PUT-Motorsport/PUTM_EV_BMS_LV_2021/Hardware/Pcb_size.dxf

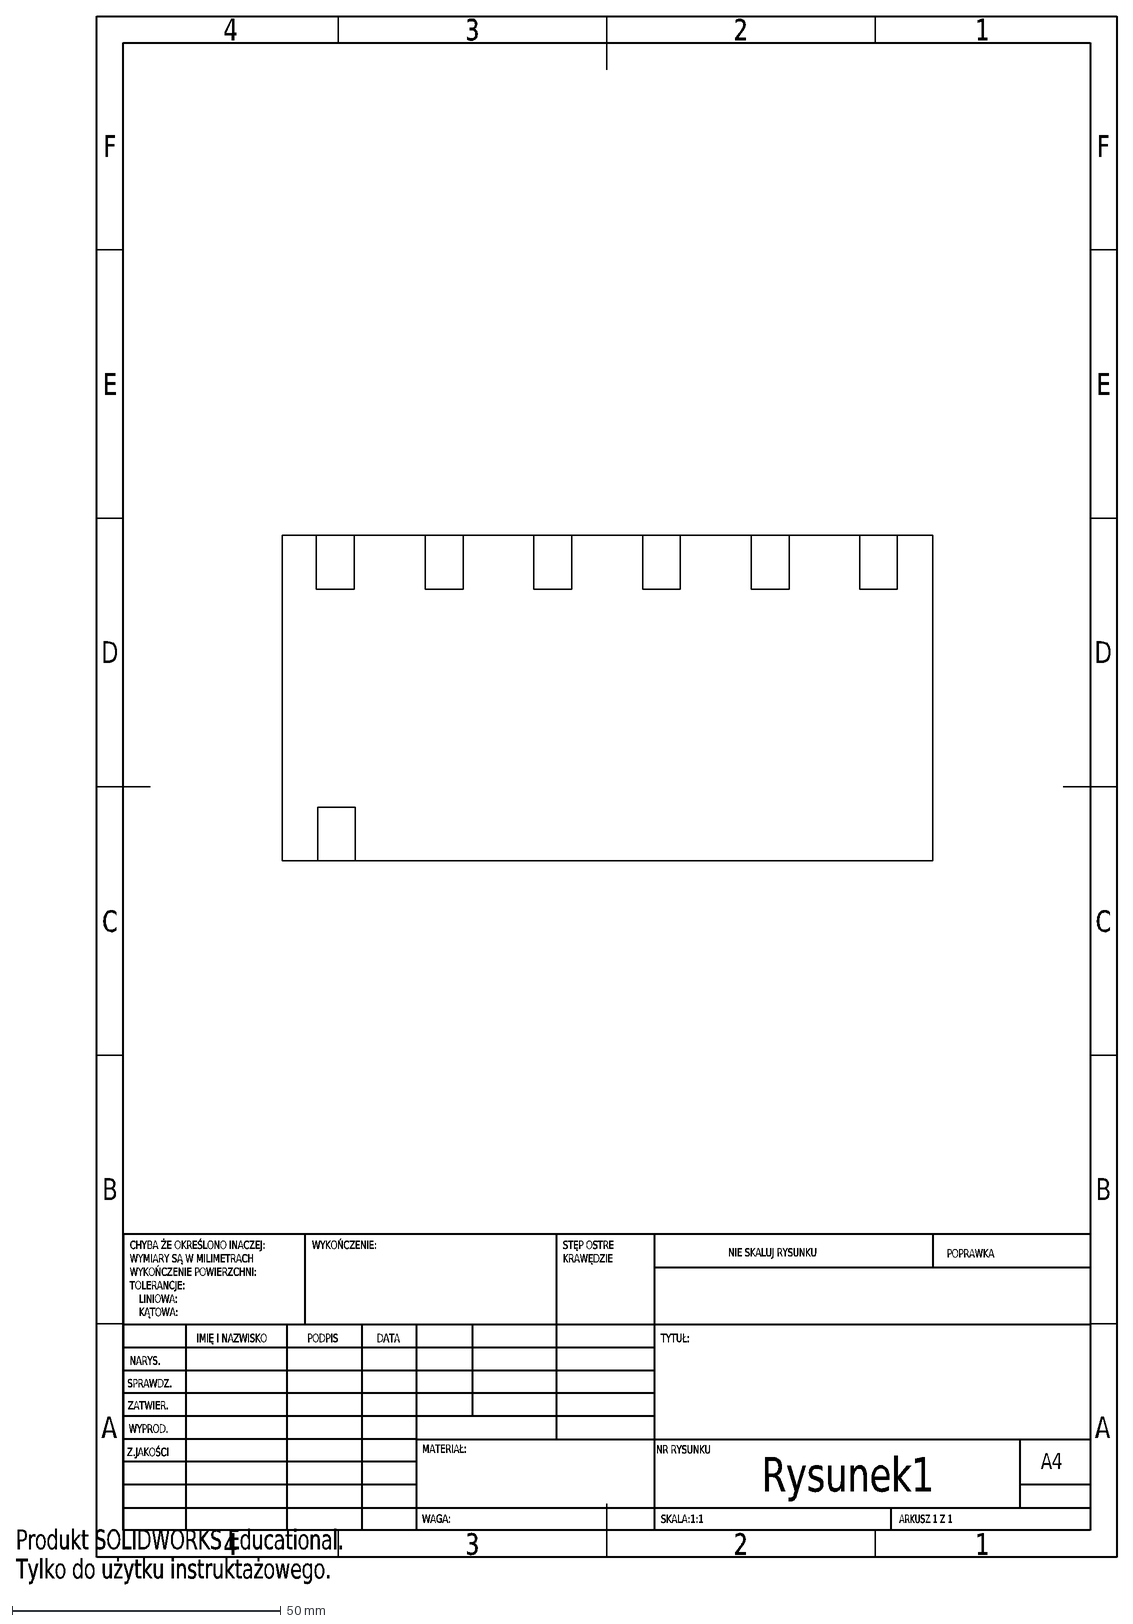
[picture p1: CAD file, 2021-02-14]
Hardware/Pcb_size.dxf
A
B
C
D
E
F
4
3
2
1
NARYS.
SPRAWDZ.
ZATWIER.
WYPROD.
Z.JAKOŚCI
CHYBA ŻE OKREŚLONO INACZEJ:
WYMIARY SĄ W MILIMETRACH
WYKOŃCZENIE POWIERZCHNI:
TOLERANCJE:
LINIOWA:
KĄTOWA:
WYKOŃCZENIE:
STĘP OSTRE
KRAWĘDZIE
IMIĘ I NAZWISKO
PODPIS
DATA
MATERIAŁ:
NIE SKALUJ RYSUNKU
POPRAWKA
TYTUŁ:
NR RYSUNKU
SKALA:1:1
ARKUSZ 1 Z 1
A4
WAGA:
Rysunek1
Produkt SOLIDWORKS Educational.
Tylko do użytku instruktażowego.
