PUT-Motorsport/PUTM_EV_BMS_LV_2021/Hardware/bmsLV.kicad_pcb

## KiCad design Hardware/bmsLV.kicad_pcb (2021-05-10)

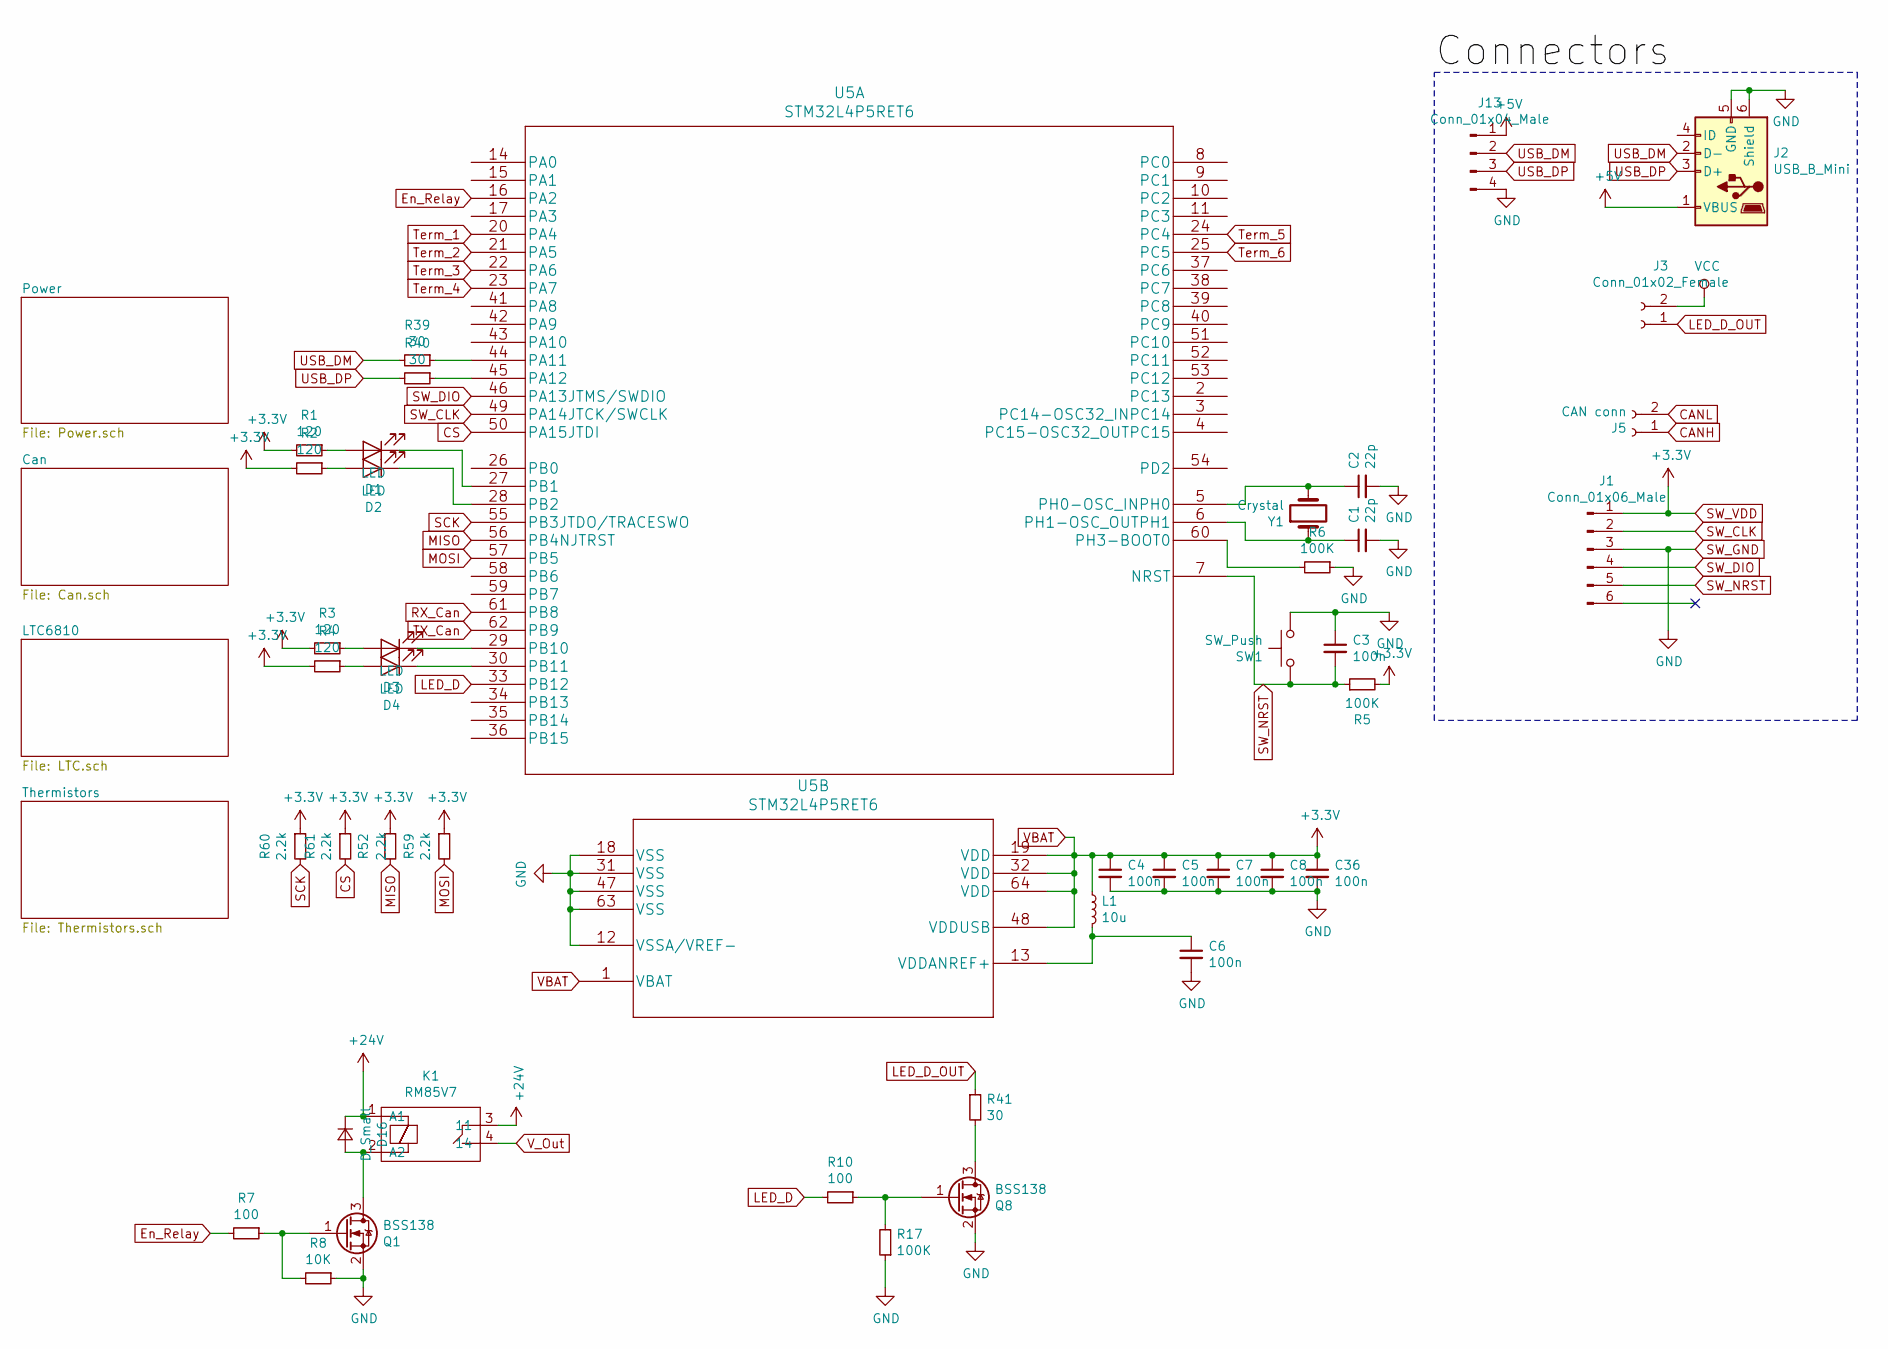
[picture p2: schematic bmsLV.sch]

Parts:
C1, C2: 22p; C_1206_3216Metric
C3, C4, C5, C6, C7, C8, C36: 100n; C_1206_3216Metric
D1, D2, D3, D4: LED; LED_1206_3216Metric
D16: D_Small; D_SMB
J1: Conn_01x06_Male; PinHeader_1x06_P2.54mm_Vertical
J2: USB_B_Mini; USB_Micro-B_Molex_47346-0001
J3: Conn_01x02_Female; PhoenixContact_MSTBVA_2,5_2-G-5,08_1x02_P5.08mm_Vertical
J5: CAN conn; PhoenixContact_MSTBVA_2,5_2-G-5,08_1x02_P5.08mm_Vertical
J13: Conn_01x04_Male; PinHeader_1x04_P2.54mm_Vertical
K1: RM85V7
L1: 10u; L_0805_2012Metric
Q1, Q8: BSS138; SOT-23
R1, R2, R3, R4: 120; R_1206_3216Metric
R5, R6, R17: 100K; R_1206_3216Metric
R7, R10: 100; R_1206_3216Metric
R8: 10K; R_1206_3216Metric
R39, R40, R41: 30; R_1206_3216Metric
R52, R59, R60, R61: 2.2k; R_1206_3216Metric
SW1: SW_Push; SW_PUSH_6mm
U5: STM32L4P5RET6
Y1: Crystal; Crystal_SMD_HC49-SD

Connections:
+5V: J2.1 (VBUS), J13.1; also elsewhere on the board
+24V: D16.1 (K), K1.1 (A1), K1.3 (11); also elsewhere on the board
CANH: J5.1; also elsewhere on the board
CANL: J5.2; also elsewhere on the board
CS: R61.2, U5.50 (PA15JTDI); also elsewhere on the board
En_Relay: R7.2, U5.16 (PA2)
LED_D: R10.2, U5.33 (PB12)
LED_D_OUT: J3.1, R41.1
MISO: R52.2, U5.56 (PB4NJTRST); also elsewhere on the board
MOSI: R59.2, U5.57 (PB5); also elsewhere on the board
unnamed: C1.1, U5.6 (PH1-OSC_OUTPH1), Y1.1
unnamed: C2.1, U5.5 (PH0-OSC_INPH0), Y1.2
unnamed: C6.1, L1.2, U5.13 (VDDANREF+)
unnamed: D1.1 (K), U5.27 (PB1)
unnamed: D1.2 (A), R1.1
unnamed: D2.1 (K), U5.28 (PB2)
unnamed: D2.2 (A), R2.1
unnamed: D3.1 (K), U5.29 (PB10)
unnamed: D3.2 (A), R3.1
unnamed: D4.1 (K), U5.30 (PB11)
unnamed: D4.2 (A), R4.1
unnamed: D16.2 (A), K1.2 (A2), Q1.3 (D)
unnamed: Q1.1 (G), R7.1, R8.2
unnamed: Q8.1 (G), R10.1, R17.2
unnamed: Q8.3 (D), R41.2
unnamed: R6.2, U5.60 (PH3-BOOT0)
unnamed: R39.1, U5.44 (PA11)
unnamed: R40.1, U5.45 (PA12)
RX_Can: U5.61 (PB8); also elsewhere on the board
SCK: R60.2, U5.55 (PB3JTDO/TRACESWO); also elsewhere on the board
SW_CLK: J1.2, U5.49 (PA14JTCK/SWCLK)
SW_DIO: J1.4, U5.46 (PA13JTMS/SWDIO)
SW_GND: C1.2, C2.2, C3.1, C4.2, C5.2, C6.2, C7.2, C8.2, C36.2, J1.3, J2.5 (GND), J2.6 (Shield), J13.4, Q1.2 (S), Q8.2 (S), R6.1, R8.1, R17.1, SW1.2, U5.12 (VSSA/VREF-), U5.18 (VSS), U5.31 (VSS), U5.47 (VSS), U5.63 (VSS); also elsewhere on the board
SW_NRST: C3.2, J1.5, R5.1, SW1.1, U5.7 (NRST)
SW_VDD: C4.1, C5.1, C7.1, C8.1, C36.1, J1.1, L1.1, R1.2, R2.2, R3.2, R4.2, R5.2, R52.1, R59.1, R60.1, R61.1, U5.1 (VBAT), U5.19 (VDD), U5.32 (VDD), U5.48 (VDDUSB), U5.64 (VDD); also elsewhere on the board
TX_Can: U5.62 (PB9); also elsewhere on the board
Term_1: U5.20 (PA4); also elsewhere on the board
Term_2: U5.21 (PA5); also elsewhere on the board
Term_3: U5.22 (PA6); also elsewhere on the board
Term_4: U5.23 (PA7); also elsewhere on the board
Term_5: U5.24 (PC4); also elsewhere on the board
Term_6: U5.25 (PC5); also elsewhere on the board
USB_DM: J2.2 (D-), J13.2, R39.2
USB_DP: J2.3 (D+), J13.3, R40.2
VCC: J3.2; also elsewhere on the board
V_Out: K1.4 (14)

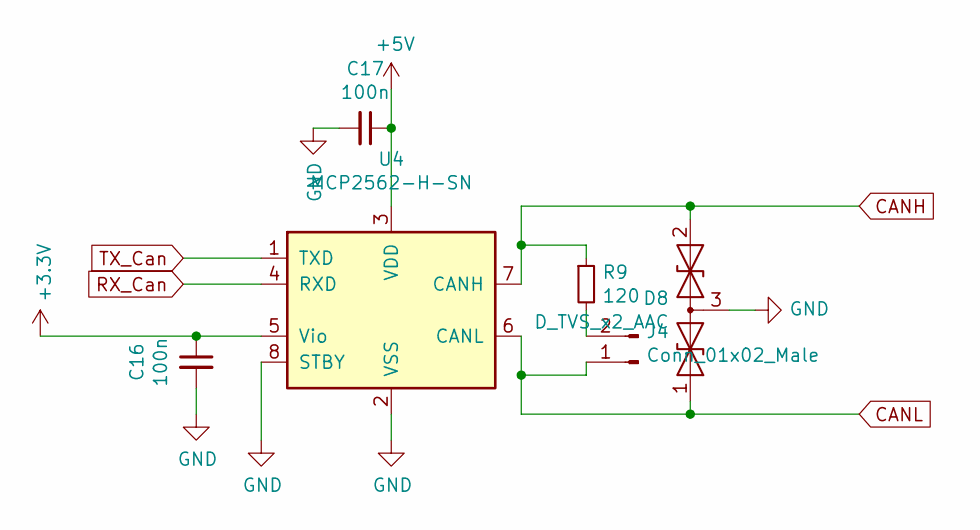
[picture p3: schematic Can.sch]

Parts:
C16, C17: 100n; C_1206_3216Metric
D8: D_TVS_x2_AAC; SOT-23
J4: Conn_01x02_Male; PinHeader_1x02_P2.54mm_Vertical
R9: 120; R_1206_3216Metric
U4: MCP2562-H-SN; SOIC-8_3.9x4.9mm_P1.27mm

Connections:
+5V: C17.1, U4.3 (VDD); also elsewhere on the board
CANH: D8.2 (A2), R9.1, U4.7 (CANH); also elsewhere on the board
CANL: D8.1 (A1), J4.1, U4.6 (CANL); also elsewhere on the board
unnamed: J4.2, R9.2
RX_Can: U4.4 (RXD); also elsewhere on the board
SW_GND: C16.2, C17.2, D8.3 (common), U4.2 (VSS), U4.8 (STBY); also elsewhere on the board
SW_VDD: C16.1, U4.5 (Vio); also elsewhere on the board
TX_Can: U4.1 (TXD); also elsewhere on the board

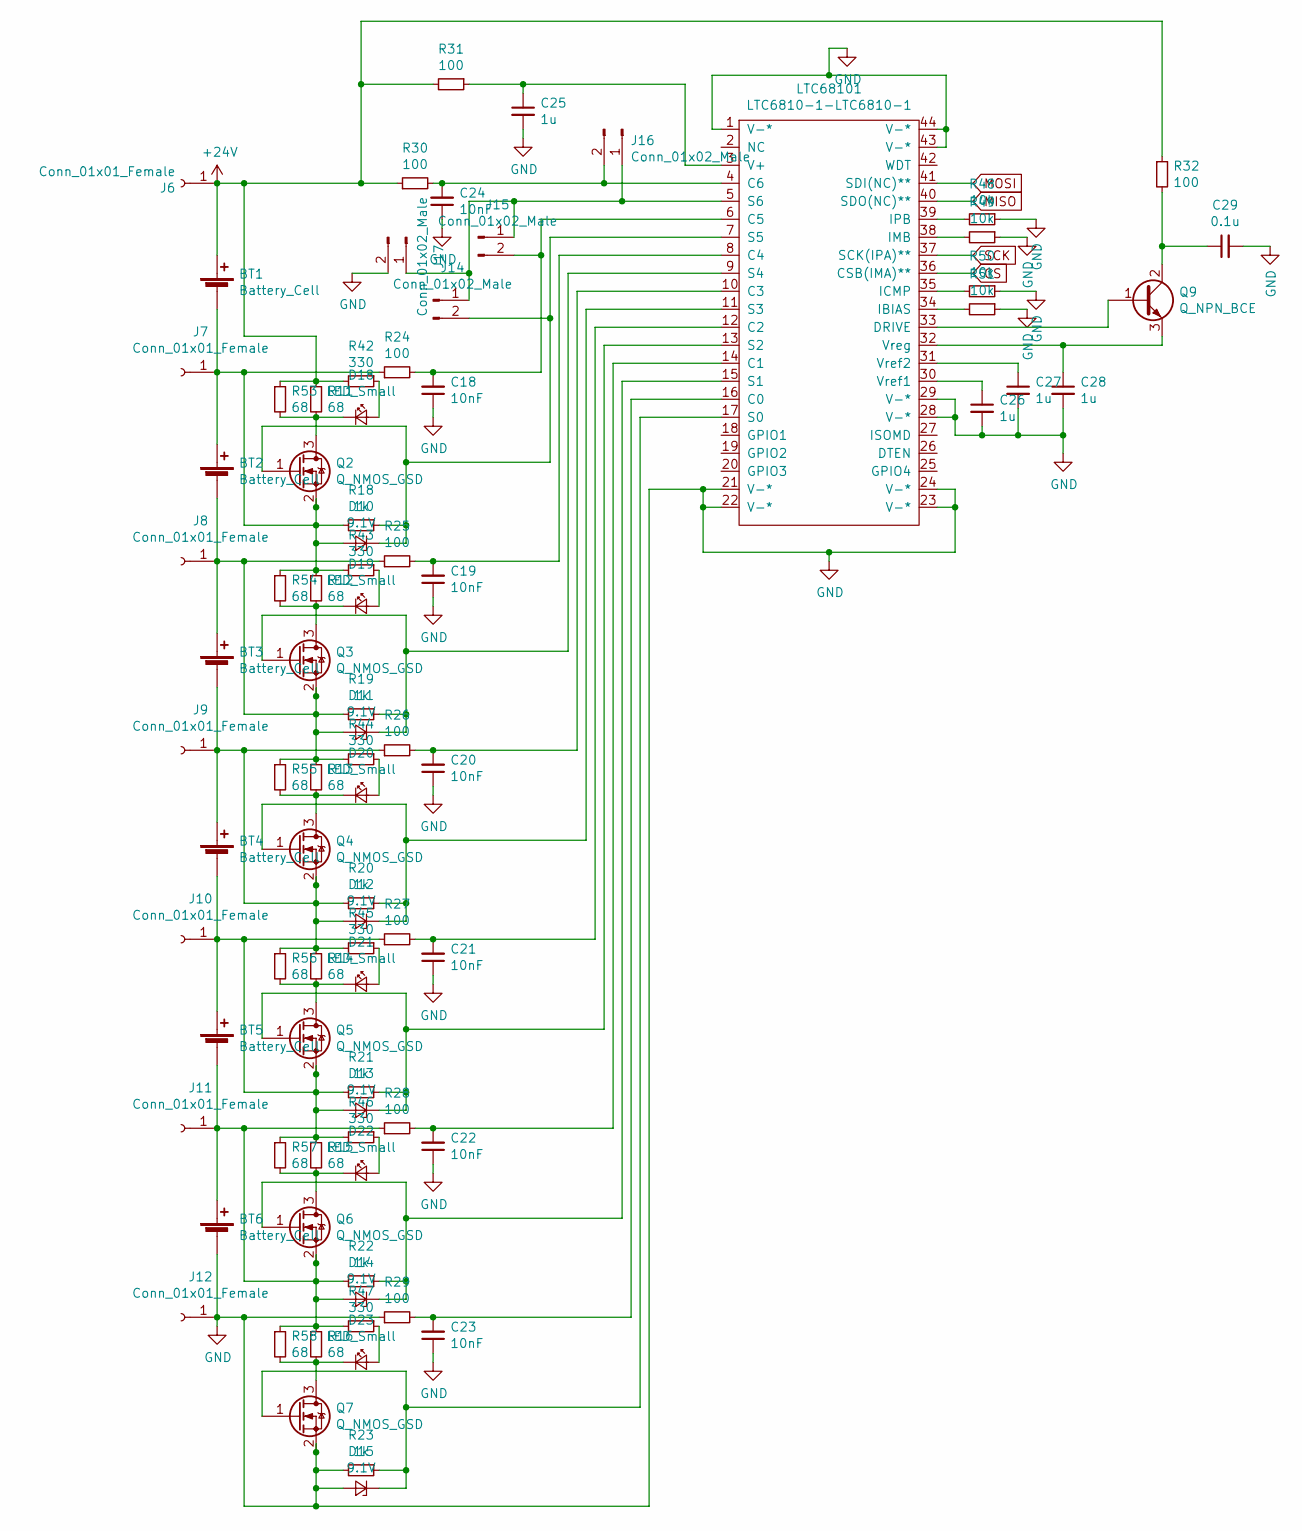
[picture p4: schematic LTC.sch]

Parts:
BT1, BT2, BT3, BT4, BT5, BT6: Battery_Cell; TerminalBlock_bornier-2_P5.08mm
C18, C19, C20, C21, C22, C23, C24: 10nF; C_1206_3216Metric
C25, C26, C27, C28: 1u; C_1206_3216Metric
C29: 0.1u; C_0603_1608Metric
D10, D11, D12, D13, D14, D15: 9.1V; D_SMB
D18, D19, D20, D21, D22, D23: LED_Small; LED_0805_2012Metric
J6, J7, J8, J9, J10, J11, J12: Conn_01x01_Female; CellPad
J14, J15, J16, J17: Conn_01x02_Male; SolderJumper-2_P1.3mm_Open_RoundedPad1.0x1.5mm
LTC68101: LTC6810-1-LTC6810-1; LTC6810
Q2, Q3, Q4, Q5, Q6, Q7: Q_NMOS_GSD; SOT-23
Q9: Q_NPN_BCE; SOT-23W
R11, R12, R13, R14, R15, R16, R53, R54, R55, R56, R57, R58: 68; R_2512_6332Metric
R18, R19, R20, R21, R22, R23: 1k; R_1206_3216Metric
R24, R25, R26, R27, R28, R29, R30, R31, R32: 100; R_1206_3216Metric
R42, R43, R44, R45, R46, R47: 330; R_1206_3216Metric
R48, R49, R50, R51: 10k; R_0805_2012Metric

Connections:
+24V: BT1.1 (+), J6.1, R11.1, R30.1, R31.2, R32.1, R42.2, R53.1; also elsewhere on the board
CS: LTC68101.36 (CSB(IMA)**); also elsewhere on the board
MISO: LTC68101.40 (SDO(NC)**); also elsewhere on the board
MOSI: LTC68101.41 (SDI(NC)**); also elsewhere on the board
unnamed: BT1.2 (-), BT2.1 (+), D10.2 (A), J7.1, Q2.2 (S), R12.1, R18.2, R24.1, R43.2, R54.1
unnamed: BT2.2 (-), BT3.1 (+), D11.2 (A), J8.1, Q3.2 (S), R13.1, R19.2, R25.1, R44.2, R55.1
unnamed: BT3.2 (-), BT4.1 (+), D12.2 (A), J9.1, Q4.2 (S), R14.1, R20.2, R26.1, R45.2, R56.1
unnamed: BT4.2 (-), BT5.1 (+), D13.2 (A), J10.1, Q5.2 (S), R15.1, R21.2, R27.1, R46.2, R57.1
unnamed: BT5.2 (-), BT6.1 (+), D14.2 (A), J11.1, Q6.2 (S), R16.1, R22.2, R28.1, R47.2, R58.1
unnamed: C18.2, J15.2, LTC68101.6 (C5), R24.2
unnamed: C19.2, LTC68101.8 (C4), R25.2
unnamed: C20.2, LTC68101.10 (C3), R26.2
unnamed: C21.2, LTC68101.12 (C2), R27.2
unnamed: C22.2, LTC68101.14 (C1), R28.2
unnamed: C23.2, LTC68101.16 (C0), R29.2
unnamed: C24.2, J16.2, LTC68101.4 (C6), R30.2
unnamed: C25.1, LTC68101.3 (V+), R31.1
unnamed: C26.1, LTC68101.30 (Vref1)
unnamed: C27.1, LTC68101.31 (Vref2)
unnamed: C28.1, LTC68101.32 (Vreg), Q9.3 (E)
unnamed: C29.1, Q9.2 (C), R32.2
unnamed: D10.1 (K), J14.2, LTC68101.7 (S5), Q2.1 (G), R18.1
unnamed: D11.1 (K), LTC68101.9 (S4), Q3.1 (G), R19.1
unnamed: D12.1 (K), LTC68101.11 (S3), Q4.1 (G), R20.1
unnamed: D13.1 (K), LTC68101.13 (S2), Q5.1 (G), R21.1
unnamed: D14.1 (K), LTC68101.15 (S1), Q6.1 (G), R22.1
unnamed: D15.1 (K), LTC68101.17 (S0), Q7.1 (G), R23.1
unnamed: D18.1 (K), Q2.3 (D), R11.2, R53.2
unnamed: D18.2 (A), R42.1
unnamed: D19.1 (K), Q3.3 (D), R12.2, R54.2
unnamed: D19.2 (A), R43.1
unnamed: D20.1 (K), Q4.3 (D), R13.2, R55.2
unnamed: D20.2 (A), R44.1
unnamed: D21.1 (K), Q5.3 (D), R14.2, R56.2
unnamed: D21.2 (A), R45.1
unnamed: D22.1 (K), Q6.3 (D), R15.2, R57.2
unnamed: D22.2 (A), R46.1
unnamed: D23.1 (K), Q7.3 (D), R16.2, R58.2
unnamed: D23.2 (A), R47.1
unnamed: J14.1, J15.1, J16.1, J17.1, LTC68101.5 (S6)
unnamed: LTC68101.33 (DRIVE), Q9.1 (B)
unnamed: LTC68101.34 (IBIAS), R51.2
unnamed: LTC68101.35 (ICMP), R50.2
unnamed: LTC68101.38 (IMB), R49.2
unnamed: LTC68101.39 (IPB), R48.2
SCK: LTC68101.37 (SCK(IPA)**); also elsewhere on the board
SW_GND: BT6.2 (-), C18.1, C19.1, C20.1, C21.1, C22.1, C23.1, C24.1, C25.2, C26.2, C27.2, C28.2, C29.2, D15.2 (A), J12.1, J17.2, LTC68101.1 (V-*), LTC68101.21 (V-*), LTC68101.22 (V-*), LTC68101.23 (V-*), LTC68101.24 (V-*), LTC68101.28 (V-*), LTC68101.29 (V-*), LTC68101.43 (V-*), LTC68101.44 (V-*), Q7.2 (S), R23.2, R29.1, R48.1, R49.1, R50.1, R51.1; also elsewhere on the board

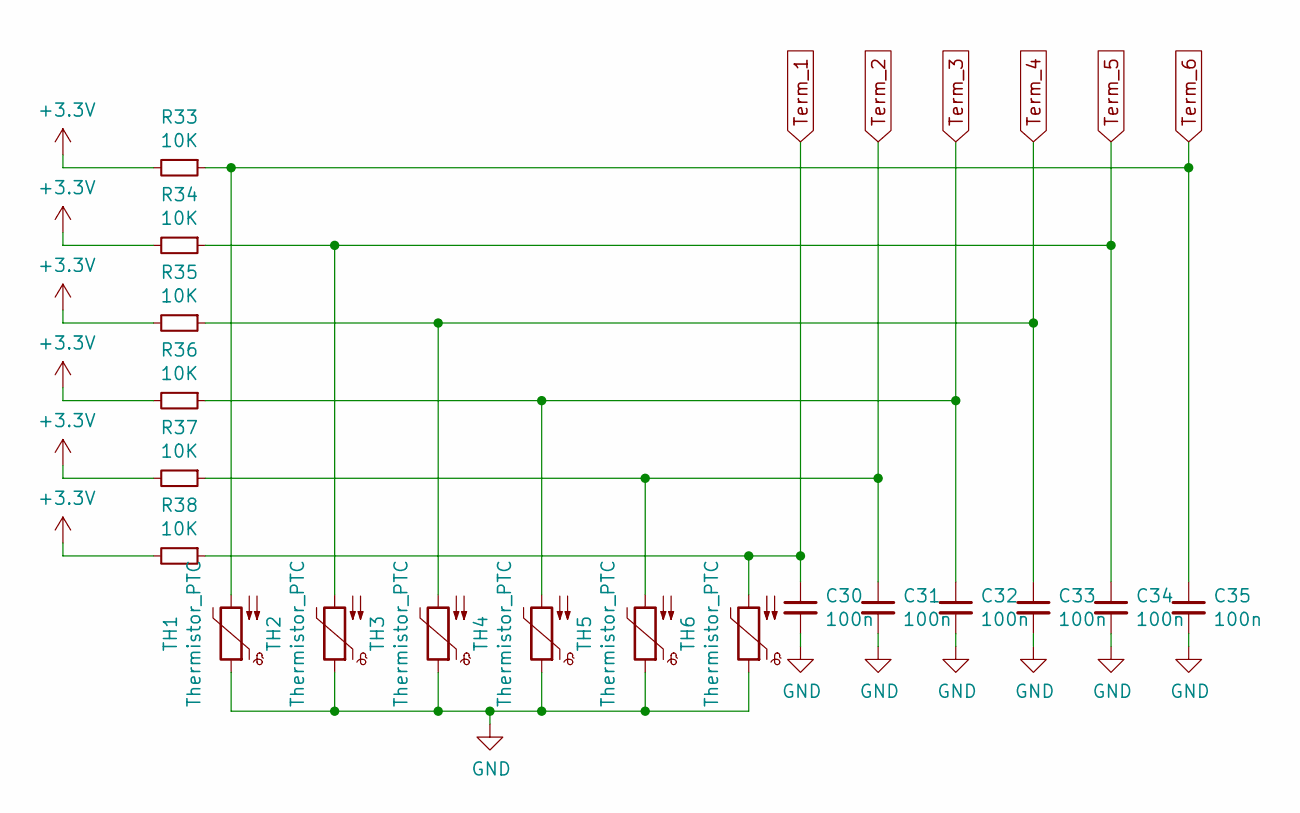
[picture p5: schematic Thermistors.sch]

Parts:
C30, C31, C32, C33, C34, C35: 100n; C_1206_3216Metric
R33, R34, R35, R36, R37, R38: 10K; R_1206_3216Metric
TH1, TH2, TH3, TH4, TH5, TH6: Thermistor_PTC; PinHeader_1x02_P2.54mm_Vertical

Connections:
SW_GND: C30.2, C31.2, C32.2, C33.2, C34.2, C35.2, TH1.1, TH2.1, TH3.1, TH4.1, TH5.1, TH6.1; also elsewhere on the board
SW_VDD: R33.2, R34.2, R35.2, R36.2, R37.2, R38.2; also elsewhere on the board
Term_1: C30.1, R38.1, TH6.2; also elsewhere on the board
Term_2: C31.1, R37.1, TH5.2; also elsewhere on the board
Term_3: C32.1, R36.1, TH4.2; also elsewhere on the board
Term_4: C33.1, R35.1, TH3.2; also elsewhere on the board
Term_5: C34.1, R34.1, TH2.2; also elsewhere on the board
Term_6: C35.1, R33.1, TH1.2; also elsewhere on the board

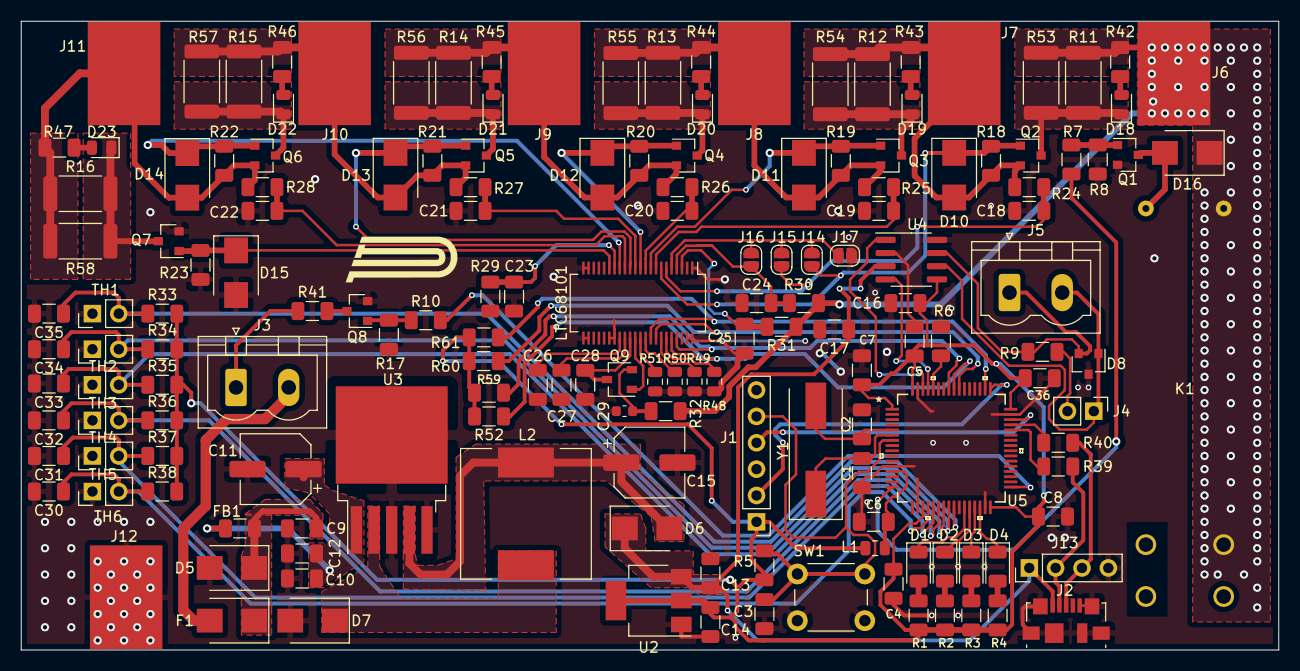
[picture p6: board bmsLV.kicad_pcb from above]

Board: 2 copper layers, 121.2 x 60.6 mm, 162 parts (0 on the bottom side), 91 nets.

Other parts of the board:
C9: 330p; C_1206_3216Metric
C10: 47n; C_1206_3216Metric
C11: 680u; CP_Elec_6.3x7.7
C12, C13, C14: 100n; C_1206_3216Metric
C15: 220uF; CP_Elec_6.3x7.7
D5, D6, D7: D_Schottky; D_SMB
F1: Fuse; D_SMB
FB1: Ferrite_Bead_Small; C_1206_3216Metric
L2: 33u; L_12x12mm_H8mm
U2: LM1117-3.3; SOT-223-3_TabPin2
U3: LM2596S-5; TO-263-5_TabPin3

Their connections:
+5V: C13.1, D6.1, U2.3; also elsewhere on the board
+5VD: C15.1, D6.2, L2.2, U3.4
unnamed: C9.1, D5.1, F1.1, FB1.2
unnamed: C10.1, C11.1, C12.1, FB1.1, U3.1
unnamed: D7.1, L2.1, U3.2
SW_GND: C9.2, C10.2, C11.2, C12.2, C13.2, C14.2, C15.2, D5.2, D7.2, U2.1, U3.3, U3.5; also elsewhere on the board
SW_VDD: C14.1, U2.2; also elsewhere on the board
VCC: F1.2; also elsewhere on the board
