PUT-Motorsport/PUTM_EV_BMS_LV_2021/Software/bmsLV-STM32L4P5RET/Core/Src/main.cpp

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
/* Includes ------------------------------------------------------------------*/
#include "main.h"
#include "usb_device.h"

/* USER CODE BEGIN Includes */
#include "stdbool.h"
#include "string.h"
#include "math.h"
#include "usbd_cdc.h"
#include "usbd_cdc_if.h"
#include "soc_ekf.h"
/* USER CODE END Includes */

/* USER CODE BEGIN PD */
//CS means CURRENT SENSOR
#define CHARGING_CUTOFF_CURRENT		0.3f
#define CS_POWER_SUPLY				5000	//5V
#define RESISTOR_1 					1500	//voltage divider up
#define RESISTOR_2 					3300	//voltage divider down
#define CS_MVOLT_TO_AMPER 			100
#define TEMPERATURE_WARNING_LIMIT	50.0f
#define TEMPERATURE_LIMIT			55.0f
#define VOL_DOWN_LIMIT				30000 	//3.3V
#define VOL_DOWN_OK					36000 	//3.6V
#define VOL_UP_LIMIT				42200 	//4.22V
#define VOL_UP_OVERCHARGE			42100
#define VOL_UP_OK					42010 	//4.201V
#define VOL_UP_NEARLY_OK			41950	//4.195V
#define VOL_UP_CHARGING_CURRENT		40000	//4V
#define MAX_SUM_VOLTAGE 			255000 	//25.5V
#define NUMBER_OF_CELLS				6
#define NEUTRAL_CS					2160
#define NEUTRAL_CURRENT_CAR 		0.3
#define COUNTER_TO_SLEEP			30000 	//18000=15min -> 15*60*1000/50 where 50 is the checkError loop time
#define UNBALANCE_LIMIT				2000 	// 0.2V
#define BALANCE_VALUE				50 		//0.005V
#define TOO_HIGH_CURRENT			27 		//27A
#define TIME_TO_START				140		//7s
#define BALANCE_TIME				10000   //10s
#define NUMBER_OF_CS_SAMPLES		500
#define MAX_CELLS_DISCHARGE_AT_ONCE	3
/* USER CODE END PD */

ADC_HandleTypeDef hadc1;
ADC_HandleTypeDef hadc2;
DMA_HandleTypeDef hdma_adc1;
DMA_HandleTypeDef hdma_adc2;

CAN_HandleTypeDef hcan1;

RTC_HandleTypeDef hrtc;

SPI_HandleTypeDef hspi1;

TIM_HandleTypeDef htim3;
TIM_HandleTypeDef htim6;
TIM_HandleTypeDef htim8;

/* USER CODE BEGIN PV */

uint8_t ltcConfig[6] = {0xFC, (uint8_t)(1874 & 0xff), (uint8_t)((1874>>4)|(2625<<4)), (uint8_t)(2625>>4), 0, 0};
uint8_t acuState;

//state of charge
SoC_EKF soc;
float socValue;
uint8_t socValueCAN;

//voltage
uint16_t cellValues[NUMBER_OF_CELLS];
uint8_t cellValuesCAN[NUMBER_OF_CELLS];
uint32_t cellValuesSum;
uint8_t cellValuesSumCAN;
float cellValuesAvg;

//temperatures
uint16_t tempValues[NUMBER_OF_CELLS];
uint16_t tempValuesCAN[NUMBER_OF_CELLS];
uint16_t tempValuesAvr;
volatile uint16_t adcValues[NUMBER_OF_CELLS];

//current
uint32_t currentSensor[NUMBER_OF_CS_SAMPLES] = {0};
float currentSensorAvg;
float chargingCurrent;
float outputCurrent = 0.0;
float outputCurrent_max = 0.0;
float outputCurrent_min = 0.0;
float outputCurrent_historic_max = 0.0;

//flags
uint32_t dataRefreshNextTick = 0;
uint8_t newData = 0;
bool can100HzFlag = 0;
bool startFlag = 0;
bool startChargingFlag = true;

//charge/discharge
uint8_t chargingState = 0;
uint8_t dischargeActivation=0;
bool cellDischarge[NUMBER_OF_CELLS];
static uint32_t dischargeTickEnd;
uint8_t dischargeAtOnce = 0;

//counters
uint8_t errorCounterLowVol[NUMBER_OF_CELLS];
uint8_t errorCounterHighVol[NUMBER_OF_CELLS];
uint8_t errorCounterHighTemp[NUMBER_OF_CELLS];
uint8_t errorCounterBalance[NUMBER_OF_CELLS];
uint8_t errorCounterHighCur;
uint16_t sleepCounter;
uint16_t startCounter;

const int temperatureMap[26][2] = {
		//	  adc value ,  temperature *C
		{4096	,	-50} ,
		{3713	,	-20} ,
		{3602	,	-15} ,
		{3469	,	-10} ,
		{3313	,	-5}	,
		{3136	,	0}	,
		{2939	,	5}	,
		{2726	,	10}	,
		{2503	,	15}	,
		{2275	,	20}	,
		{2048	,	25}	,
		{1828	,	30}	,
		{1618	,	35}	,
		{1424	,	40}	,
		{1245	,	45}	,
		{1085	,	50}	,
		{942	,	55}	,
		{816	,	60}	,
		{706	,	65}	,
		{611	,	70}	,
		{528	,	75}	,
		{458	,	80}	,
		{397	,	85}	,
		{344	,	90}	,
		{299	,	95}	,
		{261	,	100}

};

float maxCurrentSensorOutputVoltage, currentSensorVoltsToAmper, outputCurrentFactor;
/* USER CODE END PV */

void SystemClock_Config(void);
static void MX_GPIO_Init(void);
static void MX_DMA_Init(void);
static void MX_ADC1_Init(void);
static void MX_CAN1_Init(void);
static void MX_SPI1_Init(void);
static void MX_TIM3_Init(void);
static void MX_TIM6_Init(void);
static void MX_ADC2_Init(void);
static void MX_TIM8_Init(void);
static void MX_RTC_Init(void);
/* USER CODE BEGIN 0 */
uint16_t pec15Table[256];
uint16_t CRC15_POLY = 0x4599;
void init_PEC15_Table()
{
	uint16_t remainder;
	for (int i = 0; i < 256; i++)
	{
		remainder = i << 7;
		for (int bit = 8; bit > 0; --bit)
		{
			if (remainder & 0x4000)
			{
				remainder = ((remainder << 1));
				remainder = (remainder ^ CRC15_POLY);
			}
			else
			{
				remainder = ((remainder << 1));
			}
		}
		pec15Table[i] = remainder&0xFFFF;
	}
}

uint16_t pec15(char *data , int len)
{
	uint16_t remainder,address;
	remainder = 16;//PEC seed
	for (int i = 0; i < len; i++)
	{
		address = ((remainder >> 7) ^ data[i]) & 0xff;//calculate PEC table address
		remainder = (remainder << 8 ) ^ pec15Table[address];
	}
	return (remainder*2);//The CRC15 has a 0 in the LSB so the final value must be multiplied by 2
}



/**
 * Brief:	Send wakeup for LTC, BLOCKING MODE
 * Param:	None
 * Retval:	None
 */
void LTC_wakeUp()
{
	uint8_t tab[2] = {0xFF};

	HAL_GPIO_WritePin(SPI1_CS_GPIO_Port, SPI1_CS_Pin, GPIO_PIN_RESET);
	HAL_SPI_Transmit(&hspi1, tab, 2, 1);
	HAL_GPIO_WritePin(SPI1_CS_GPIO_Port, SPI1_CS_Pin, GPIO_PIN_SET);
}


/**
 * Brief:	Send adc config for ltc and start conversion, BLOCKING MODE
 * Param:	None
 * Retval:	None
 */
void LTC_startCellAdc()
{
	uint8_t tab[12];
	uint16_t pec;

	uint16_t cmd = (1<<15) | 0x01;
	// configuration
	tab[0] = (cmd>>8);
	tab[1] = cmd;
	pec = pec15((char*)tab, 2);
	tab[2] = pec >> 8;
	tab[3] = pec;

	tab[4] = ltcConfig[0];
	tab[5] = ltcConfig[1];
	tab[6] = ltcConfig[2];
	tab[7] = ltcConfig[3];
	tab[8] = ltcConfig[4];
	tab[9] = ltcConfig[5];
	pec = pec15((char*)&tab[4], 6);
	tab[10] = pec >> 8;
	tab[11] = pec;

	LTC_wakeUp();

	HAL_GPIO_WritePin(SPI1_CS_GPIO_Port, SPI1_CS_Pin, GPIO_PIN_RESET);
	HAL_SPI_Transmit(&hspi1, tab, 12, 100);
	HAL_GPIO_WritePin(SPI1_CS_GPIO_Port, SPI1_CS_Pin, GPIO_PIN_SET);


	// adc conversion
	memset(tab, 0, 12);

	//cmd = 0b1001100000 | (0b00 << 7); // discharge not permitted
	cmd = 0b1001110000 | (0b00 << 7); // discharge permitted
	tab[0] = cmd>>8;
	tab[1] = cmd;
	pec = pec15((char*)tab, 2);
	tab[2] = pec >> 8;
	tab[3] = pec;

	HAL_GPIO_WritePin(SPI1_CS_GPIO_Port, SPI1_CS_Pin, GPIO_PIN_RESET);
	HAL_SPI_Transmit(&hspi1, tab, 4, 100);
	HAL_GPIO_WritePin(SPI1_CS_GPIO_Port, SPI1_CS_Pin, GPIO_PIN_SET);
}



/**
 * Brief:	Receveing adc data from ltc, BLOCKING MODE
 * Param:	None
 * Retval:	None
 */
void LTC_getValuesAdc()
{
	uint8_t tab[100], rx_tab[100];
	uint16_t pec;

	// read cell voltage group A
	uint16_t cmd = (1<<15) | 0b100;
	memset(tab, 0, 12);
	tab[0] = (cmd>>8);
	tab[1] = cmd;
	pec = pec15((char*)tab, 2);
	tab[2] = pec >> 8;
	tab[3] = pec;

	LTC_wakeUp();

	HAL_GPIO_WritePin(SPI1_CS_GPIO_Port, SPI1_CS_Pin, GPIO_PIN_RESET);
	HAL_SPI_TransmitReceive(&hspi1, tab, rx_tab, 12, 100);
	HAL_GPIO_WritePin(SPI1_CS_GPIO_Port, SPI1_CS_Pin, GPIO_PIN_SET);


	cellValues[0] = (uint16_t)rx_tab[4] | (((uint16_t)rx_tab[5])<<8);
	cellValues[1] = (uint16_t)rx_tab[6] | (((uint16_t)rx_tab[7])<<8);
	cellValues[2] = (uint16_t)rx_tab[8] | (((uint16_t)rx_tab[9])<<8);


	// read cell voltage group B
	cmd = (1<<15) | 0b110;
	memset(tab, 0, 12);
	tab[0] = (cmd>>8);
	tab[1] = cmd;
	pec = pec15((char*)tab, 2);
	tab[2] = pec >> 8;
	tab[3] = pec;

	HAL_GPIO_WritePin(SPI1_CS_GPIO_Port, SPI1_CS_Pin, GPIO_PIN_RESET);
	HAL_SPI_TransmitReceive(&hspi1, tab, rx_tab, 12, 100);
	HAL_GPIO_WritePin(SPI1_CS_GPIO_Port, SPI1_CS_Pin, GPIO_PIN_SET);

	cellValues[3] = (uint16_t)rx_tab[4] | (((uint16_t)rx_tab[5])<<8);
	cellValues[4] = (uint16_t)rx_tab[6] | (((uint16_t)rx_tab[7])<<8);
	cellValues[5] = (uint16_t)rx_tab[8] | (((uint16_t)rx_tab[9])<<8);

	cellValuesSum  = cellValues[0];

	//cells sum calculations for CAN
	for(unsigned int i = 1; i < NUMBER_OF_CELLS; i++)
	{
		cellValuesSum += cellValues[i];
	}

	cellValuesAvg = ((float)cellValuesSum / 6) / 10000;

	if(cellValuesSum > MAX_SUM_VOLTAGE){
		cellValuesSum = MAX_SUM_VOLTAGE;
	}

	cellValuesSumCAN = cellValuesSum / 1000;


}


/**
 * Brief:	Calculation of temperature, from value of measured voltage
 * Param:	value:	Value of voltage, LSB -> 0.1 mV
 * Retval:	Temperature in *C
 */
float tempCalculate(uint16_t value)
{
	float retval = 0.0;
	for(unsigned int i = 1; i < 28; i++)
	{
		if(value >= (uint16_t)temperatureMap[i][0])
		{
			// approximation
			retval = (float)temperatureMap[i][1] - 5.0 * ((float)value-(float)temperatureMap[i][0]) / ((float)temperatureMap[i-1][0] - (float)temperatureMap[i][0]);
			break;
		}
	}
	return retval;
}

/**
 * Brief:	Getting proper values of temperatures on every cell in *C
 * Param:	None
 * Retval:	None
 */
void getTemp()
{
	tempValuesAvr = 0;
	for(unsigned int i = 0; i < NUMBER_OF_CELLS; i++)
	{
		tempValues[i] = (uint16_t)tempCalculate(adcValues[i]);
		tempValuesAvr += tempValues[i];
	}
	tempValuesAvr = tempValuesAvr / 6;
}
/**
 * Brief:	Muting discharge
 * Param:	None
 * Retval:	None
 */
void muteDis()
{
	uint8_t tab[4];
	uint16_t pec;


	uint16_t cmd = (1<<15) | 0b101000;
	memset(tab, 0, 4);
	tab[0] = (cmd>>8);
	tab[1] = cmd;
	pec = pec15((char*)tab, 2);
	tab[2] = pec >> 8;
	tab[3] = pec;

	LTC_wakeUp();

	HAL_GPIO_WritePin(SPI1_CS_GPIO_Port, SPI1_CS_Pin, GPIO_PIN_RESET);
	HAL_SPI_Transmit(&hspi1, tab, 4, 100);
	HAL_GPIO_WritePin(SPI1_CS_GPIO_Port, SPI1_CS_Pin, GPIO_PIN_SET);
}
/**
 * Brief:	Unmuting discharge
 * Param:	None
 * Retval:	None
 */
void unmuteDis()
{
	uint8_t tab[4];
	uint16_t pec;


	uint16_t cmd = (1<<15) | 0b101001;
	memset(tab, 0, 4);
	tab[0] = (cmd>>8);
	tab[1] = cmd;
	pec = pec15((char*)tab, 2);
	tab[2] = pec >> 8;
	tab[3] = pec;

	LTC_wakeUp();

	HAL_GPIO_WritePin(SPI1_CS_GPIO_Port, SPI1_CS_Pin, GPIO_PIN_RESET);
	HAL_SPI_Transmit(&hspi1, tab, 4, 100);
	HAL_GPIO_WritePin(SPI1_CS_GPIO_Port, SPI1_CS_Pin, GPIO_PIN_SET);
}

/**
 * Brief:	Send discharge configuration and start the discharge, BLOCKING MODE
 * Param:	cell: number of cell wanted to be discharged
 * Retval:	None
 */
void LTC_turnOnDischarge(int cell)
{
	uint8_t tab[12];
	uint16_t pec;

	unmuteDis();

	uint16_t cmd = (1<<15) | 0b10100;
	memset(tab, 0, 12);
	tab[0] = (cmd>>8);
	tab[1] = cmd;
	pec = pec15((char*)tab, 2);
	tab[2] = pec >> 8;
	tab[3] = pec;


	tab[4] = (cellDischarge[0]) | (cellDischarge[1] << 4); // 1, 2
	tab[5] = (cellDischarge[2]) | (cellDischarge[3] << 4); // 3, 4
	tab[6] = (cellDischarge[4]) | (cellDischarge[5] << 4); // 5, 6
	tab[7] = 0;
	tab[8] = 0;
	tab[9] = 0;
	pec = pec15((char*)&tab[4], 6);
	tab[10] = pec >> 8;
	tab[11] = pec;

	LTC_wakeUp();

	HAL_GPIO_WritePin(SPI1_CS_GPIO_Port, SPI1_CS_Pin, GPIO_PIN_RESET);
	HAL_SPI_Transmit(&hspi1, tab, 12, 100);
	HAL_GPIO_WritePin(SPI1_CS_GPIO_Port, SPI1_CS_Pin, GPIO_PIN_SET);

	cmd = (1<<15) | 0x01;
	memset(tab, 0, 12);
	// configuration
	tab[0] = (cmd>>8);
	tab[1] = cmd;
	pec = pec15((char*)tab, 2);
	tab[2] = pec >> 8;
	tab[3] = pec;

	tab[4] = ltcConfig[0];
	tab[5] = ltcConfig[1];
	tab[6] = ltcConfig[2];
	tab[7] = ltcConfig[3];
	if(cell<7){
		ltcConfig[4] = ltcConfig[4] | (1 << (cell));
	}
	tab[8] = ltcConfig[4];
	tab[9] = ltcConfig[5];
	pec = pec15((char*)&tab[4], 6);
	tab[10] = pec >> 8;
	tab[11] = pec;


	HAL_GPIO_WritePin(SPI1_CS_GPIO_Port, SPI1_CS_Pin, GPIO_PIN_RESET);
	HAL_SPI_Transmit(&hspi1, tab, 12, 100);
	HAL_GPIO_WritePin(SPI1_CS_GPIO_Port, SPI1_CS_Pin, GPIO_PIN_SET);


}

/**
 * Brief:	Turn off discharge, BLOCKING MODE
 * Param:	None
 * Retval:	None
 */
void LTC_turnOffDischarge()
{

	uint8_t tab[100];
	uint16_t pec;


	uint16_t cmd = (1<<15) | 0b10100;
	memset(tab, 0, 12);
	tab[0] = (cmd>>8);
	tab[1] = cmd;
	pec = pec15((char*)tab, 2);
	tab[2] = pec >> 8;
	tab[3] = pec;


	tab[4] = 0;
	tab[5] = 0;
	tab[6] = 0;
	tab[7] = 0;
	tab[8] = 0;
	tab[9] = 0;
	pec = pec15((char*)&tab[4], 6);
	tab[10] = pec >> 8;
	tab[11] = pec;

	LTC_wakeUp();

	HAL_GPIO_WritePin(SPI1_CS_GPIO_Port, SPI1_CS_Pin, GPIO_PIN_RESET);
	HAL_SPI_Transmit(&hspi1, tab, 12, 100);
	HAL_GPIO_WritePin(SPI1_CS_GPIO_Port, SPI1_CS_Pin, GPIO_PIN_SET);


	cmd = (1<<15) | 0x01;
	memset(tab, 0, 12);
	// configuration
	tab[0] = (cmd>>8);
	tab[1] = cmd;
	pec = pec15((char*)tab, 2);
	tab[2] = pec >> 8;
	tab[3] = pec;

	ltcConfig[4] = 0;

	tab[4] = ltcConfig[0];
	tab[5] = ltcConfig[1];
	tab[6] = ltcConfig[2];
	tab[7] = ltcConfig[3];
	tab[8] = ltcConfig[4];
	tab[9] = ltcConfig[5];
	pec = pec15((char*)&tab[4], 6);
	tab[10] = pec >> 8;
	tab[11] = pec;

	HAL_GPIO_WritePin(SPI1_CS_GPIO_Port, SPI1_CS_Pin, GPIO_PIN_RESET);
	HAL_SPI_Transmit(&hspi1, tab, 12, 100);
	HAL_GPIO_WritePin(SPI1_CS_GPIO_Port, SPI1_CS_Pin, GPIO_PIN_SET);

	muteDis();
}

/**
 * Brief:	CAN initialization
 * Param:	None
 * Retval:	None
 */
void canInit()
{
	CAN_FilterTypeDef filter;
	filter.FilterActivation = ENABLE;
	filter.FilterBank = 10;
	filter.FilterFIFOAssignment = CAN_FILTER_FIFO0;
	filter.FilterIdHigh = 0x00;
	filter.FilterIdLow = 0x00;
	filter.FilterMaskIdHigh = 0x00;
	filter.FilterMaskIdLow = 0x00;
	filter.FilterMode = CAN_FILTERMODE_IDMASK;
	filter.FilterScale = CAN_FILTERSCALE_32BIT;
	filter.SlaveStartFilterBank = 10;

	HAL_CAN_ConfigFilter(&hcan1, &filter);
	HAL_CAN_ActivateNotification(&hcan1, CAN_IT_RX_FIFO0_MSG_PENDING);
	HAL_CAN_Start(&hcan1);

}
/**
 * Brief:	Control of cell discharges
 * Param:	None
 * Retval:	None
 */
void balanceControl()
{
	uint8_t chargedCells = 0, chargedCells2 = 0, cellOver = 0;
	uint16_t lowestValue, maxValue, maxValueD;
	bool maxV = 0, maxVOutOfCharge = 0;
	lowestValue = cellValues[0];
	maxValue = cellValues[0];
	for(unsigned int i = 0; i < NUMBER_OF_CELLS; i++)
	{
		if(lowestValue > cellValues[i])
		{
			lowestValue = cellValues[i];
		}
		if(maxValue < cellValues[i])
		{
			maxValue = cellValues[i];
			maxValueD = i;
		}
		if(cellValues[maxValueD] > VOL_UP_OK || (cellValues[maxValueD] - lowestValue) > BALANCE_VALUE)
		{
			maxV = true;
		}
		if(cellValues[maxValueD] > VOL_UP_OK)
		{
			maxVOutOfCharge = true;
		}
		if(cellValues[i] > VOL_UP_OK)
		{
			chargedCells++;
		}
		if(cellValues[i] > VOL_UP_NEARLY_OK)
		{
			chargedCells2++;
		}
		if(cellValues[i] > VOL_UP_OVERCHARGE)
		{
			cellOver++;
		}
	}
	if(chargingState == 1)
	{
		if(dischargeActivation == 0)
		{
			for(int i = 0; i < NUMBER_OF_CELLS; i++)
			{
				if(maxV == true)
				{
					maxV = false;
					if(dischargeAtOnce < MAX_CELLS_DISCHARGE_AT_ONCE)
					{
						cellDischarge[maxValueD] = 1;
						dischargeAtOnce++;
						i = maxValueD + 1;
					}
					dischargeActivation = 1;
					dischargeTickEnd = HAL_GetTick() + BALANCE_TIME;
					if(i > 4){
						i = -1;
					}
				}
				else if(cellValues[i] > VOL_UP_OK)
				{

					if(dischargeAtOnce < MAX_CELLS_DISCHARGE_AT_ONCE)
					{
						cellDischarge[i] = 1;
						dischargeAtOnce++;
						i++;
					}
					dischargeActivation = 1;
					dischargeTickEnd = HAL_GetTick()+BALANCE_TIME;
				}
				else if((cellValues[i] - lowestValue) > BALANCE_VALUE)
				{
					if(dischargeAtOnce < MAX_CELLS_DISCHARGE_AT_ONCE)
					{
						cellDischarge[i] = 1;
						dischargeAtOnce++;
						i++;
					}
					dischargeActivation = 1;
					dischargeTickEnd = HAL_GetTick()+BALANCE_TIME;
				}
				else
					cellDischarge[i] = 0;

				if(cellValues[i] >= VOL_UP_CHARGING_CURRENT) chargingCurrent = fabsf(outputCurrent);
			}
		}
	}
	else if(0 == chargingState)
	{
		HAL_GPIO_WritePin(LED_3_GPIO_Port, LED_3_Pin, GPIO_PIN_SET);
		//dischargeActivation = 0;

		/*for(int i = 0; i < NUMBER_OF_CELLS; i++)
		{
			cellDischarge[i] = 0;
		}*/
	}

	if(dischargeActivation == 0)
	{

		for(int i = 0; i < NUMBER_OF_CELLS; i++)
		{
			if(maxVOutOfCharge == true)
			{
				maxVOutOfCharge = false;
				if(dischargeAtOnce < MAX_CELLS_DISCHARGE_AT_ONCE)
				{
					cellDischarge[maxValueD] = 1;
					dischargeAtOnce++;
					i = maxValueD + 1;
				}
				dischargeActivation = 1;
				dischargeTickEnd = HAL_GetTick() + BALANCE_TIME;
				if(i > 4){
					i = -1;
				}
			}
			else if(cellValues[i] > VOL_UP_OK)
			{

				if(dischargeAtOnce < MAX_CELLS_DISCHARGE_AT_ONCE)
				{
					cellDischarge[i] = 1;
					dischargeAtOnce++;
					i++;
				}
				dischargeActivation = 1;
				dischargeTickEnd = HAL_GetTick()+BALANCE_TIME;
			}

			else
				cellDischarge[i] = 0;
		}
	}

	if(chargedCells >= 4 && fabsf(outputCurrent) < CHARGING_CUTOFF_CURRENT && chargedCells2 == 6)
	{
		HAL_GPIO_WritePin(RELAY_GPIO_Port, RELAY_Pin, GPIO_PIN_RESET);
		HAL_GPIO_WritePin(LED_3_GPIO_Port, LED_3_Pin, GPIO_PIN_SET);
		chargingState = 0;
		soc.set_full_battery();
	}else if(cellOver > 1){
		HAL_GPIO_WritePin(RELAY_GPIO_Port, RELAY_Pin, GPIO_PIN_RESET);
		HAL_GPIO_WritePin(LED_3_GPIO_Port, LED_3_Pin, GPIO_PIN_SET);
	}else if(HAL_GPIO_ReadPin(LED_2_GPIO_Port, LED_2_Pin) == 0 && chargedCells2 < 6 && dischargeActivation == 0 && cellOver == 0 && acuState == 0)
	{
		HAL_GPIO_WritePin(RELAY_GPIO_Port, RELAY_Pin, GPIO_PIN_SET);
		chargingState = 1;
	}

}

void HAL_TIM_PeriodElapsedCallback(TIM_HandleTypeDef *htim)
{
	if(htim->Instance == TIM3)
	{
		can100HzFlag = 1;
	}

}
/**
 * Brief:	Calculations of output current
 * Param:	None
 * Retval:	None
 */
void calculateCurrent()
{
	//float raw_sum = 0, raw_max = INT32_MIN, raw_min = INT32_MAX, maxCurrentSensorOutputVoltage, currentSensorVoltsToAmper, outputCurrentFactor;
	float raw_sum = 0, raw_max = INT32_MIN, raw_min = INT32_MAX;
	for(int i = 0; i < NUMBER_OF_CS_SAMPLES; i++)
	{
		int16_t raw_value = currentSensor[i];
		raw_sum += raw_value;
		if(raw_value > raw_max) raw_max = raw_value;
		if(raw_value < raw_min) raw_min = raw_value;
	}
	currentSensorAvg = raw_sum / NUMBER_OF_CS_SAMPLES;

	currentSensorAvg -= NEUTRAL_CS;
	raw_max -= NEUTRAL_CS;
	raw_min -= NEUTRAL_CS;

	maxCurrentSensorOutputVoltage = ((float)(CS_POWER_SUPLY * RESISTOR_2) / (float)(RESISTOR_1 + RESISTOR_2)) / 1000;
	currentSensorVoltsToAmper = ((float)(CS_MVOLT_TO_AMPER * RESISTOR_2) / (float)(RESISTOR_1 + RESISTOR_2)) / 1000;
	outputCurrentFactor = maxCurrentSensorOutputVoltage / 4096 * (1 / currentSensorVoltsToAmper);

	outputCurrent = currentSensorAvg * outputCurrentFactor;
	outputCurrent_max = (float)raw_max * outputCurrentFactor;
	outputCurrent_min = (float)raw_min * outputCurrentFactor;

	if(outputCurrent_historic_max < outputCurrent_max)
		outputCurrent_historic_max = outputCurrent_max;
	if(outputCurrent < -NEUTRAL_CURRENT_CAR)
	{
		chargingState = 1;
	}else if (outputCurrent >= 0 || HAL_GPIO_ReadPin(LED_2_GPIO_Port, LED_2_Pin) == 1){
		chargingState = 0;
	}

}

/**
 * Brief:	Checking values and switching off safety
 * Param:	None
 * Retval:	None
 */
void checkError()
{
	uint16_t lowestValue;
	lowestValue=cellValues[0];
	for(int i = 1; i < NUMBER_OF_CELLS; i++)
	{
		if(lowestValue > cellValues[i])
		{
			lowestValue = cellValues[i];
		}
	}

	if(HAL_GPIO_ReadPin(LED_2_GPIO_Port, LED_2_Pin) == 0 && startChargingFlag == true) //LED_2 read is an interlock in charger connector
	{
		HAL_GPIO_WritePin(RELAY_GPIO_Port, RELAY_Pin, GPIO_PIN_SET);
		startChargingFlag = false;
		acuState = 0;
	}
	for(int i = 0; i < NUMBER_OF_CELLS; i++)
	{
		if (HAL_GPIO_ReadPin(LED_2_GPIO_Port, LED_2_Pin) == 1){
			if((cellValues[i] - lowestValue) > UNBALANCE_LIMIT)
			{
				errorCounterBalance[i]++;
			}else{
				errorCounterBalance[i]=0;
			}
			if(cellValues[i] < VOL_DOWN_LIMIT)
			{
				errorCounterLowVol[i]++;
			}else{
				errorCounterLowVol[i]=0;
			}
		}
		if(cellValues[i] > VOL_UP_LIMIT)
		{
			errorCounterHighVol[i]++;
		}else{
			errorCounterHighVol[i]=0;
		}
		if(tempValues[i] > TEMPERATURE_LIMIT)
		{
			errorCounterHighTemp[i]++;
		}else{
			errorCounterHighTemp[i]=0;
		}
		/*if(cellValues[i] < 30000)
		{
			sleep mode
		}*/
	}

	if(fabsf(outputCurrent) <= NEUTRAL_CURRENT_CAR)
	{
		sleepCounter++;
	}else{
		sleepCounter = 0;
	}
	if(outputCurrent > TOO_HIGH_CURRENT)
	{
		errorCounterHighCur++;
	}else{
		errorCounterHighCur = 0;
	}

	//EVERY COUNTER IS MULTIPLIED BY 50MS. IT IS A TIME!

	for(int i = 0; i < NUMBER_OF_CELLS; i++)
	{
		if(errorCounterLowVol[i] >= 9)
		{
			acuState = 0b1; //too low voltage
			if(errorCounterLowVol[i] == 10)
			{
				HAL_GPIO_WritePin(RELAY_GPIO_Port, RELAY_Pin, GPIO_PIN_RESET);

				HAL_GPIO_WritePin(LED_3_GPIO_Port, LED_3_Pin, GPIO_PIN_RESET);
			}
		}
		if(errorCounterHighVol[i] >= 9)
		{
			acuState = 0b10; //too high voltage
			if(errorCounterHighVol[i] == 10)
			{
				HAL_GPIO_WritePin(RELAY_GPIO_Port, RELAY_Pin, GPIO_PIN_RESET);
				//HAL_GPIO_WritePin(LED_3_GPIO_Port, LED_3_Pin, RESET);
			}
		}
		if(errorCounterHighTemp[i] >= 19)
		{
			acuState = 0b11; //too high temp
			if(errorCounterHighTemp[i] == 20)
			{
				HAL_GPIO_WritePin(RELAY_GPIO_Port, RELAY_Pin, GPIO_PIN_RESET);

				HAL_GPIO_WritePin(LED_4_GPIO_Port, LED_4_Pin, GPIO_PIN_RESET);
			}
		}
		if(errorCounterBalance[i] >= 9)
		{
			acuState = 0b100; //not balanced
			if(errorCounterBalance[i] == 10)
			{
				//it should be some kind of warning instead of RELAY reset- LED on Dash should be fine
				HAL_GPIO_WritePin(RELAY_GPIO_Port, RELAY_Pin, GPIO_PIN_RESET);
				//HAL_GPIO_WritePin(LED_4_GPIO_Port, LED_4_Pin, RESET);
			}
		}
		//if(cellValues[i] > 37000 && cellValues[i] <= 42200 && tempValues[i] < 40 && sleepCounter < COUNTER_TO_SLEEP)
		//{
		//	HAL_GPIO_WritePin(RELAY_GPIO_Port, RELAY_Pin, SET);
		//}
	}


	if(errorCounterHighCur >= 9)
	{
		acuState = 0b101; //too high current
		if(errorCounterHighCur == 10)
		{
			HAL_GPIO_WritePin(RELAY_GPIO_Port, RELAY_Pin, GPIO_PIN_RESET);

			HAL_GPIO_WritePin(LED_4_GPIO_Port, LED_4_Pin, GPIO_PIN_RESET);
			HAL_GPIO_WritePin(LED_3_GPIO_Port, LED_3_Pin, GPIO_PIN_RESET);
		}
	}

	if(sleepCounter == COUNTER_TO_SLEEP){
		acuState = 0b110; //Relay permanently switched off- need to reset
		HAL_GPIO_WritePin(RELAY_GPIO_Port, RELAY_Pin, GPIO_PIN_RESET);
		HAL_PWR_EnterSTOPMode(PWR_LOWPOWERREGULATOR_ON, PWR_STOPENTRY_WFI);
	}


}
/**
 * Brief:	First CAN message
 * Param:	None
 * Retval:	None
 */
void canData_1()
{
	CAN_TxHeaderTypeDef tx_header;
	tx_header.DLC = 8;
	tx_header.IDE = CAN_ID_STD;
	tx_header.RTR = CAN_RTR_DATA;
	tx_header.StdId = 0x0C;
	uint8_t data[8];

	for(int i = 0; i < NUMBER_OF_CELLS; i++)
	{
		cellValuesCAN[i] = cellValues[i] / 1000;
	}

	socValueCAN = socValue * 100; //1% accuracy
	/*
	 * acuState:
	 * 0- all good
	 * 1- too low voltage
	 * 2- too high voltage
	 * 3- too high temperature
	 * 4- cells are not balanced (difference from lowest to any >0.2V)
	 * 5- too high current
	 * 6- relay permanently switched off- need to reset
	 */

	data[0] = acuState;
	data[1] = socValueCAN;
	data[2] = cellValuesCAN[0];
	data[3] = cellValuesCAN[1];
	data[4] = cellValuesCAN[2];
	data[5] = cellValuesCAN[3];
	data[6] = cellValuesCAN[4];
	data[7] = cellValuesCAN[5];

	uint32_t mailbox = 0;
	HAL_CAN_AddTxMessage(&hcan1, &tx_header, data, &mailbox);
}
/**
 * Brief:	Second CAN message
 * Param:	None
 * Retval:	None
 */
void canData_2()
{
	CAN_TxHeaderTypeDef tx_header;
	tx_header.DLC = 8;
	tx_header.IDE = CAN_ID_STD;
	tx_header.RTR = CAN_RTR_DATA;
	tx_header.StdId = 0x5F;
	uint8_t data[7];

	tempValuesCAN[0] = tempValues[5];
	tempValuesCAN[1] = tempValues[2];
	tempValuesCAN[2] = tempValues[4];
	tempValuesCAN[3] = tempValues[1];
	tempValuesCAN[4] = tempValues[3];
	tempValuesCAN[5] = tempValues[0];
	//mixed because of thermistor placement

	data[0] = tempValuesAvr;
	data[1] = tempValuesCAN[0];
	data[2] = tempValuesCAN[1];
	data[3] = tempValuesCAN[2];
	data[4] = tempValuesCAN[3];
	data[5] = tempValuesCAN[4];
	data[6] = tempValuesCAN[5];

	uint32_t mailbox = 0;
	HAL_CAN_AddTxMessage(&hcan1, &tx_header, data, &mailbox);
}

/**
 * Brief:	Activation of balance
 * Param:	None
 * Retval:	None
 */
void balanceActivation()
{
	if(dischargeActivation == 1)
	{
		for(int i = 0; i < NUMBER_OF_CELLS ; i++)
		{
			if(cellDischarge[i] == 1)
			{
				LTC_turnOnDischarge(i);
			}
		}

	}
	else
	{
		LTC_turnOffDischarge();
	}
}
/**
 * Brief:	Serial print through USB- all voltages, temperatures and output current (min, max, historical max and active)
 * Param:	None
 * Retval:	None
 */
void serialPrint()
{
	static char tab[3500];
	uint16_t n=0;

	RTC_DateTypeDef rtc_date;
	RTC_TimeTypeDef rtc_time;
	HAL_RTC_GetTime(&hrtc, &rtc_time, RTC_FORMAT_BIN);
	HAL_RTC_GetDate(&hrtc, &rtc_date, RTC_FORMAT_BIN);

	float cellValuesSumF = (float)cellValuesSum / 10000;
	n += sprintf(&tab[n], "%02d:%02d:%02d\r\n", rtc_time.Hours, rtc_time.Minutes, rtc_time.Seconds);
	n += sprintf(&tab[n], "*** Battery state: %d ***", acuState);
	n += sprintf(&tab[n], "\n");
	n += sprintf(&tab[n], "LEGEND FOR BATTERY STATE:");
	n += sprintf(&tab[n], "\n");
	n += sprintf(&tab[n], "0- all good");
	n += sprintf(&tab[n], "\n");
	n += sprintf(&tab[n], "1- too low voltage");
	n += sprintf(&tab[n], "\n");
	n += sprintf(&tab[n], "2- too high voltage");
	n += sprintf(&tab[n], "\n");
	n += sprintf(&tab[n], "3- too high temperature");
	n += sprintf(&tab[n], "\n");
	n += sprintf(&tab[n], "4- cells are not balanced (difference from lowest to any >0.2V)");
	n += sprintf(&tab[n], "\n");
	n += sprintf(&tab[n], "5- too high current");
	n += sprintf(&tab[n], "\n");
	n += sprintf(&tab[n], "6- relay permanently switched off- need to reset");
	n += sprintf(&tab[n], "\r\n\n");
	n += sprintf(&tab[n], "*** Stack voltage:\t%3.2f V ***", cellValuesSumF);
	n += sprintf(&tab[n], "\n");
	n += sprintf(&tab[n], "*** State of charge: %f ***", socValue * 100);
	n += sprintf(&tab[n], "\r\n");

	for(int i = 0; i < NUMBER_OF_CELLS; i++)
	{
		float cellValue = (float)cellValues[i] / 10000;
		n += sprintf(&tab[n], "-V.%d-\t", i+1);
		n += sprintf(&tab[n], "%1.3f%c\t", cellValue, cellDischarge[i] == 0 ? ' ' : '*');
		n += sprintf(&tab[n], " -T.%d-\t", i+1);
		n += sprintf(&tab[n], "%d\t", tempValuesCAN[i]);
		n += sprintf(&tab[n], "\r\n");
	}

	n += sprintf(&tab[n], "\r\n");
	n += sprintf(&tab[n], "Output current:\t%3.2f\r\n", outputCurrent);
	n += sprintf(&tab[n], "Max current:\t%3.2f\r\n", outputCurrent_max);
	n += sprintf(&tab[n], "Min current:\t%3.2f\r\n", outputCurrent_min);
	n += sprintf(&tab[n], "Historic max:\t%3.2f\r\n", outputCurrent_historic_max);
	n += sprintf(&tab[n], "\r\n");

	n += sprintf(&tab[n], "Relay state:\t%d\r\n", HAL_GPIO_ReadPin(RELAY_GPIO_Port, RELAY_Pin));
	n += sprintf(&tab[n], "\r\n");

	CDC_Transmit_FS((uint8_t*)tab, n);
}



/* USER CODE END 0 */

/**
  * @brief  The application entry point.
  * @retval int
  */
int main(void)
{
  /* MCU Configuration--------------------------------------------------------*/

  /* Reset of all peripherals, Initializes the Flash interface and the Systick. */
  HAL_Init();

  /* Configure the system clock */
  SystemClock_Config();

  /* Initialize all configured peripherals */
  MX_GPIO_Init();
  MX_DMA_Init();
  MX_ADC1_Init();
  MX_CAN1_Init();
  MX_SPI1_Init();
  MX_TIM3_Init();
  MX_TIM6_Init();
  MX_ADC2_Init();
  MX_TIM8_Init();
  MX_RTC_Init();
  MX_USB_DEVICE_Init();
  /* USER CODE BEGIN 2 */
	HAL_Delay(2000);

	init_PEC15_Table();

	HAL_GPIO_WritePin(RELAY_GPIO_Port, RELAY_Pin, GPIO_PIN_SET);

	canInit();

	HAL_TIM_Base_Start_IT(&htim3);
	HAL_TIM_Base_Start(&htim6);
	HAL_TIM_Base_Start(&htim8);

	// define detail single cell dynamic model
	const float ICR18650[] = {0.05016, 115.753797, 20.957554, 0.024685, 0.013414, 3.0};
	const float Li_Ion_ocv[] = {418.7120, -1685.2339, 2773.2511, -2389.3256, 1135.4684,
			-277.8532, 22.4610, 3.9510, 2.7624};
	const unsigned int Li_Ion_ocv_length = sizeof(Li_Ion_ocv) / sizeof(Li_Ion_ocv[0]);
	static_assert(SOC_OCV_poli_coeff_lenght == Li_Ion_ocv_length, "update define soc-ocv curve");

	SoC_EKF soc;
	soc.set_single_cell_equivalent_model(ICR18650);
	soc.set_single_cell_ocv_polinomial(Li_Ion_ocv, Li_Ion_ocv_length);
	soc.set_battery_configuration(1, 3);
	soc.set_time_sampling(0.05f);
	soc.set_update_matrix();
	soc.set_initial_SoC(0.5);
	//soc.update_SoC_based_on_voltage((float)cellValues[0]/10000);

  /* USER CODE END 2 */

  /* Infinite loop */
  /* USER CODE BEGIN WHILE */

	HAL_ADCEx_Calibration_Start(&hadc1, ADC_SINGLE_ENDED);
	HAL_ADCEx_Calibration_Start(&hadc2, ADC_SINGLE_ENDED);

	HAL_ADC_Start_DMA(&hadc1, (uint32_t*)adcValues, NUMBER_OF_CELLS);
	HAL_ADC_Start_DMA(&hadc2, (uint32_t*)currentSensor, NUMBER_OF_CS_SAMPLES);


	dataRefreshNextTick = HAL_GetTick();
	uint8_t chargingLED = 0;
	uint8_t skip = 0;
	bool first_init_soc = true;

	while (1)
	{
		if(dataRefreshNextTick <= HAL_GetTick())
		{
			dataRefreshNextTick += 50; //50ms loop


			// discharge off while adc
			//LTC_turnOffDischarge();

			HAL_Delay(1);
			LTC_startCellAdc();
			HAL_Delay(30);

			// on discharge if needed
			//if(dischargeActivation == 1)
			//	  {
			//		  LTC_turnOnDischarge();
			//	  }

			LTC_getValuesAdc();

			getTemp();

			chargingLED++;

			newData = 1;

			if(dischargeTickEnd <= HAL_GetTick())
			{
				dischargeActivation = 0;
				dischargeTickEnd = 0;
				dischargeAtOnce = 0;
				for(int i = 0; i < NUMBER_OF_CELLS; i++)
				{
					cellDischarge[i] = 0;
				}
				skip++;
			}

			if(startFlag == 1){
				if(abs(outputCurrent) < NEUTRAL_CURRENT_CAR)
				{
					startCounter++;
				}
			}

			if(first_init_soc){
				float temp_voltage = (float)cellValues[0] / 10000.0f;
				soc.update_SoC_based_on_voltage(temp_voltage);
				first_init_soc = false;
			}else{
				float temp_voltage = (float)cellValues[0] / 10000.0f;
				soc.update(outputCurrent, temp_voltage);
				socValue = soc.get_SoC();
			}
		}

		if(newData == 1)
		{
			newData = 0;

			calculateCurrent();

			// accumulator status
			checkError();

			if(skip == 10)
			{
				balanceControl();
				skip = 0;
			}else if(dischargeTickEnd > HAL_GetTick()){
				balanceControl();
			}

			if(chargingState == 1 && chargingLED == 10)
			{
				HAL_GPIO_TogglePin(LED_3_GPIO_Port, LED_3_Pin);
				chargingLED = 0;
			}

			// balance activation
			balanceActivation();

			//Serial Print through USB
			serialPrint();

		}
		if(can100HzFlag == 1)
		{
			canData_1();
			canData_2();
			can100HzFlag = 0;
		}

		//reset through magnet
		/*if(6 == acuState)
		{
			if(fabsf(outputCurrent) > 2.5)
			{
				startFlag = 1;
			}
		}
		if(startCounter >= TIME_TO_START)
		{
			acuState = 0;
			startFlag = 0;
			startCounter = 0;
			HAL_GPIO_WritePin(RELAY_GPIO_Port, RELAY_Pin, GPIO_PIN_SET);
		}*/
		//LTC_turnOnDischarge(1); //balance test

    /* USER CODE END WHILE */

    /* USER CODE BEGIN 3 */
	}
  /* USER CODE END 3 */
}

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
