PUT-Motorsport/PUTM_EV_BMS_LV_2021/Software/bmsLV-STM32L4P5RET/bmsLV-STM32L4P5RET.ioc

Mcu.UserName=STM32L4P5RETx
PA11.Signal=USB_OTG_FS_DM
PA12.Signal=USB_OTG_FS_DP
PA2.GPIO_Label=RELAY
PA2.Signal=GPIO_Output
PA4.GPIO_Label=TERM_1
PA4.Signal=ADCx_IN9
PA5.GPIO_Label=TERM_2
PA5.Signal=ADCx_IN10
PA6.GPIO_Label=TERM_3
PA6.Signal=ADCx_IN11
PA7.GPIO_Label=TERM_4
PA7.Signal=ADCx_IN12
PB1.GPIO_Label=SENSOR
PB1.Signal=ADCx_IN16
PB10.GPIO_Label=LED_3
PB10.Signal=GPIO_Output
PB11.GPIO_Label=LED_4
PB11.Signal=GPIO_Output
PB12.GPIO_Label=LED_DASH
PB12.Signal=GPIO_Output
PB2.GPIO_Label=LED_2
PB2.Signal=GPIO_Output
PB5.Signal=SPI1_MOSI
PB8.Signal=CAN1_RX
PB9.Signal=CAN1_TX
PC4.GPIO_Label=TERM_5
PC4.Signal=ADCx_IN13
PC5.GPIO_Label=TERM_6
PC5.Signal=ADCx_IN14
