PUT-Motorsport/PUTM_EV_BMS_LV_2021/Software/bmsLV-STM32L4P5RET/Core/Inc/main.h

#define RELAY_Pin GPIO_PIN_2
#define RELAY_GPIO_Port GPIOA
#define TERM_1_Pin GPIO_PIN_4
#define TERM_1_GPIO_Port GPIOA
#define TERM_2_Pin GPIO_PIN_5
#define TERM_2_GPIO_Port GPIOA
#define TERM_3_Pin GPIO_PIN_6
#define TERM_3_GPIO_Port GPIOA
#define TERM_4_Pin GPIO_PIN_7
#define TERM_4_GPIO_Port GPIOA
#define TERM_5_Pin GPIO_PIN_4
#define TERM_5_GPIO_Port GPIOC
#define TERM_6_Pin GPIO_PIN_5
#define TERM_6_GPIO_Port GPIOC
#define SENSOR_Pin GPIO_PIN_1
#define SENSOR_GPIO_Port GPIOB
#define LED_2_Pin GPIO_PIN_2
#define LED_2_GPIO_Port GPIOB
#define LED_3_Pin GPIO_PIN_10
#define LED_3_GPIO_Port GPIOB
#define LED_4_Pin GPIO_PIN_11
#define LED_4_GPIO_Port GPIOB
#define LED_DASH_Pin GPIO_PIN_12
#define LED_DASH_GPIO_Port GPIOB
#define SW_DIO_Pin GPIO_PIN_13
#define SW_DIO_GPIO_Port GPIOA
#define SW_CLK_Pin GPIO_PIN_14
#define SW_CLK_GPIO_Port GPIOA
#define SPI1_CS_Pin GPIO_PIN_15
#define SPI1_CS_GPIO_Port GPIOA
