PUT-Motorsport/PUTM_EV_BMS_LV_2021/(commit log)

2021-01-09 Hardware init
    Scheme ready
    [BOM_BMSLV.xlsx, Can.sch, LTC.sch, Thermistors.sch, bms1.sch, bmsLV.kicad_pcb, bmsLV.sch, power.sch]
2021-01-09 Deleted wrong files
    [bms1.sch]
2021-01-09 Cosmetic changes in files
    [BOM_BMSLV.xlsx, LTC.sch]
2021-01-14 Power update
    [Can.sch, LTC.sch, Thermistors.sch, bmsLV.sch, power.sch]
2021-02-14 Save before ZCO version
    [Pcb_size.dxf, bmsLV.kicad_pcb, bmsLV.sch, power.sch]
2021-02-15 ZCO version
    [LTC.sch, bmsLV.kicad_pcb]
2021-02-24 Save before ZCO version- back
    [Pcb_size.dxf, bmsLV.kicad_pcb, bmsLV.sch, power.sch]
2021-02-24 Save before ZCO version- back 2
    [bmsLV.kicad_pcb]
2021-02-24 Save before ZCO version- back 3
    [bmsLV.kicad_pcb]
2021-02-24 Going back to work
    [LTC.sch, Pcb_size.dxf, bmsLV.kicad_pcb, bmsLV.sch, power.sch]
2021-02-25 pcb layout nearly done
    [Can.sch, LTC.sch, Thermistors.sch, bmsLV.kicad_pcb, bmsLV.sch, power.sch]
2021-02-26 PCB layout v1
    [Can.sch, LTC.sch, Thermistors.sch, bmsLV.kicad_pcb, bmsLV.sch, power.sch]
2021-03-04 PCB v2
    changes in scheme:
    NMOS->PMOS in LTC balance
    S6 LTC pinout deleted
    another discharge resistor added on every S# LTC pinout and value changed from 30 to 68 on both
    PCB changes:
    CAN position changed
    [Can.sch, LTC.sch, Thermistors.sch, bmsLV.kicad_pcb, bmsLV.sch, power.sch]
2021-03-12 PCB finished
    PCB finished and ready to check
    [Can.sch, LTC.sch, Thermistors.sch, bmsLV.kicad_pcb, bmsLV.sch, power.sch]
2021-04-12 PCB changes + MXCube
    -gitignore added to the Hardware and Software sections
    -Changed power section wiring on PCB
    -MXCube file created as a beginning of Software section
    [LTC.sch, bmsLV.kicad_pcb, bmsLV.sch]
2021-04-13 J13, J14, J15 footprint change
    [Can.sch, LTC.sch, Thermistors.sch, bmsLV.kicad_pcb, bmsLV.sch, power.sch]
2021-04-13 Dash Led and jumpers
    -output to Dash Led created
    -added another jumper (J17) to ground
    -J14, J15, J16 jumper position changed
    [Can.sch, LTC.sch, Thermistors.sch, bmsLV.kicad_pcb, bmsLV.sch, power.sch]
2021-04-19 Connector footrpint changed
    [bmsLV.kicad_pcb, bmsLV.sch]
2021-04-22 Relay 3D model
    Relay 3D model added to footprint.
    Footprint of that relay changed a little.
    [bmsLV.kicad_pcb]
2021-04-29 STM changed
    Due to the lack of processors on market, we decided to change STM32F103C8T6 for STM32F4P5RET. So the schematic and PCB is significantly changed in this area.
    Furthermore, the library and footprint to new processor was added.
    [LTC.sch, bmsLV.kicad_pcb, bmsLV.sch]
2021-04-29 Update pcb
    Small update of some elements signatures
    [bmsLV.kicad_pcb]
2021-04-30 CS and CLK pull up added
    [bmsLV.kicad_pcb, bmsLV.sch]
2021-05-02 Checked By SS
    [bmsLV.kicad_pcb]
2021-05-03 Some changes
    [Can.sch, LTC.sch, Thermistors.sch, bmsLV.kicad_pcb, bmsLV.sch, power.sch]
2021-05-05 PUTM Logos added
    [bmsLV.kicad_pcb]
2021-05-10 gitignore modified
    [bmsLV.kicad_pcb]
2021-05-10 footprint update
    [Can.sch, LTC.sch, Thermistors.sch, bmsLV.sch, power.sch]
2021-06-24 Software update (check description)
    -SPI connection with LTC
    -CAN functions (init and Tx)
    -measuring of all cell voltage
    -some balance functions (not ended tho)
    -check error function (need to test it)
    I didnt add any functions related to temperatures.
    [bmsLV-STM32L4P5RET.ioc, main.c, main.h]
2021-07-01 Software update 2
    -ADC and temperatures functions added
    -Check error function rewrited and tested
    -Some changes in CAN massages
    Everythink works except cell balancing.
    [bmsLV-STM32L4P5RET.ioc, main.c]
2021-08-05 Software update 3
    Current sensor added to PCB (through wires)
    Current sensor handling added
    Cell balance working! (HUGE PART OF UPDATE)
    CheckError function modified (a lot of more error added)
    Serial print function added (not tested)
    + some cosmetic changes
    [Can.sch, LTC.sch, Thermistors.sch, bmsLV.sch, power.sch]
2021-08-06 Software update 4
    -Working serial print through USB
    -Code lifting (useless variables removed, some comments added and general code cleaning)
2021-08-22 State of Charge feature added
    State of Charge feature added
    + balance function changed in the last charging part
    + cosmetic changes
2021-09-19 Balance function changed
    Balance function changed in the last part of charging
